kuba2k2/T1200/ExpAdapter/hardware/v1.0/ExpAdapter_v1.0-sch.png

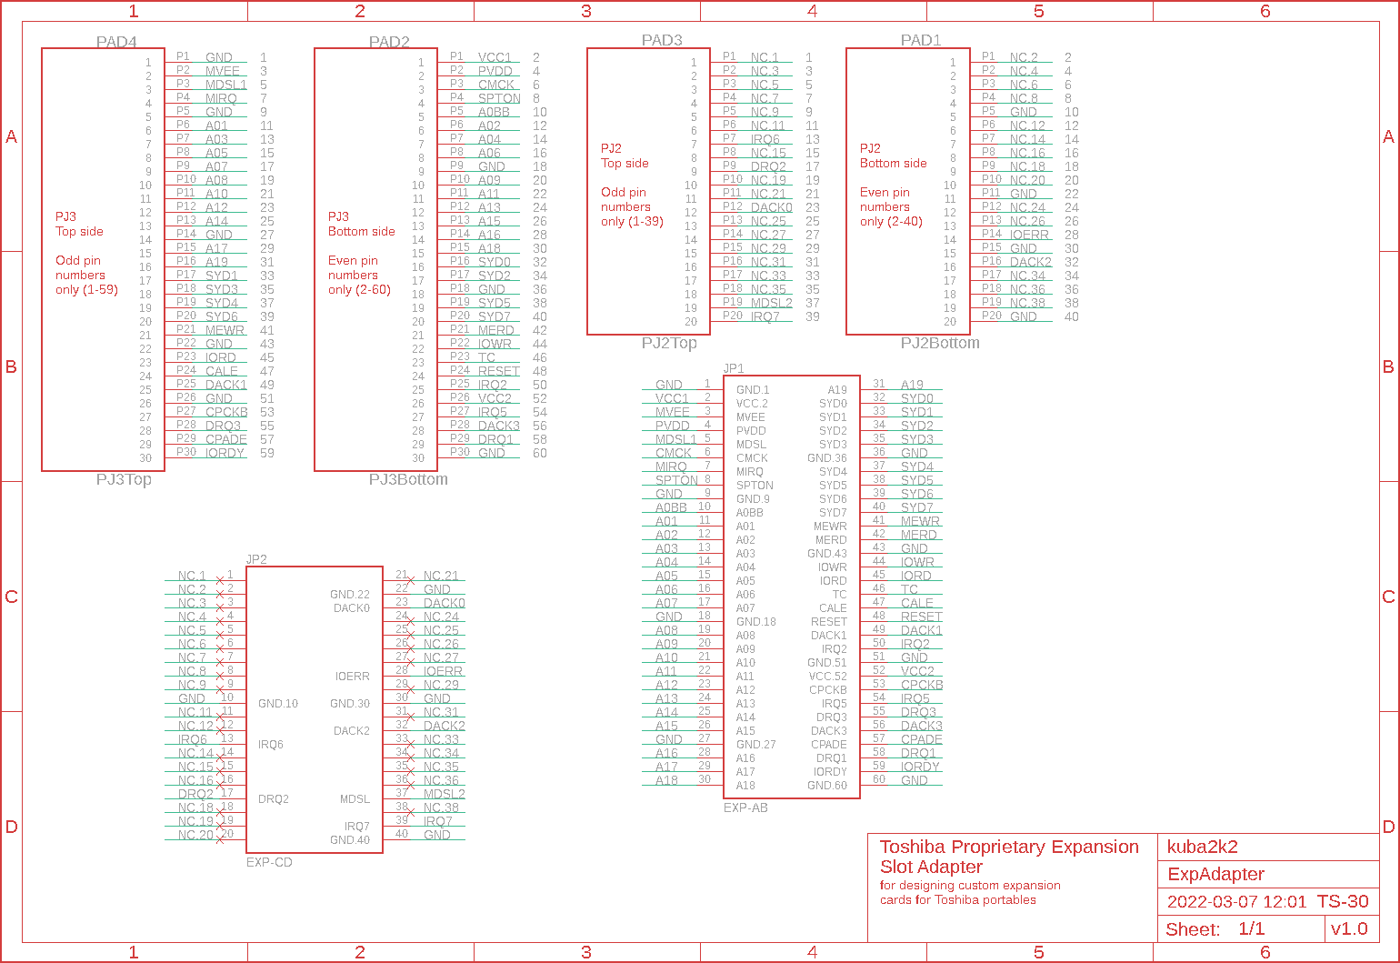
ExpAdapter/hardware/v1.0/ExpAdapter_v1.0-sch.png
