kuba2k2/T1200/ExpAdapter/hardware/v1.0/ExpAdapter_v1.0-top.png

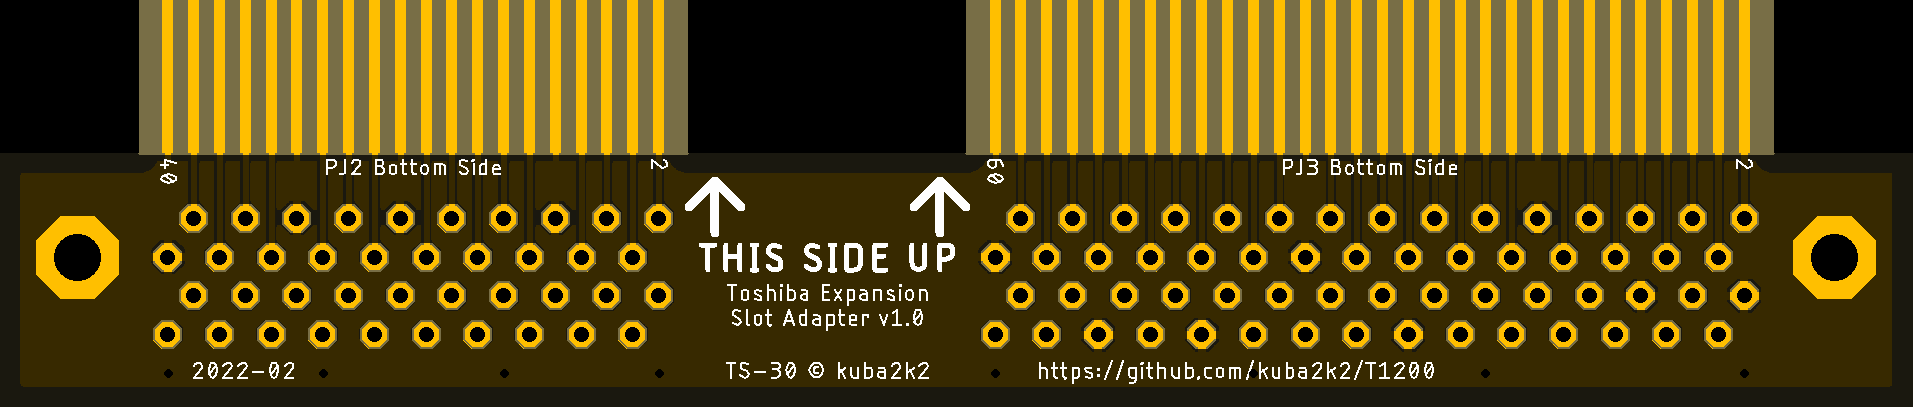
ExpAdapter/hardware/v1.0/ExpAdapter_v1.0-top.png
