kuba2k2/T1200/PSU/hardware/v1.0/PSU_v1.0-sch-sheet1.png

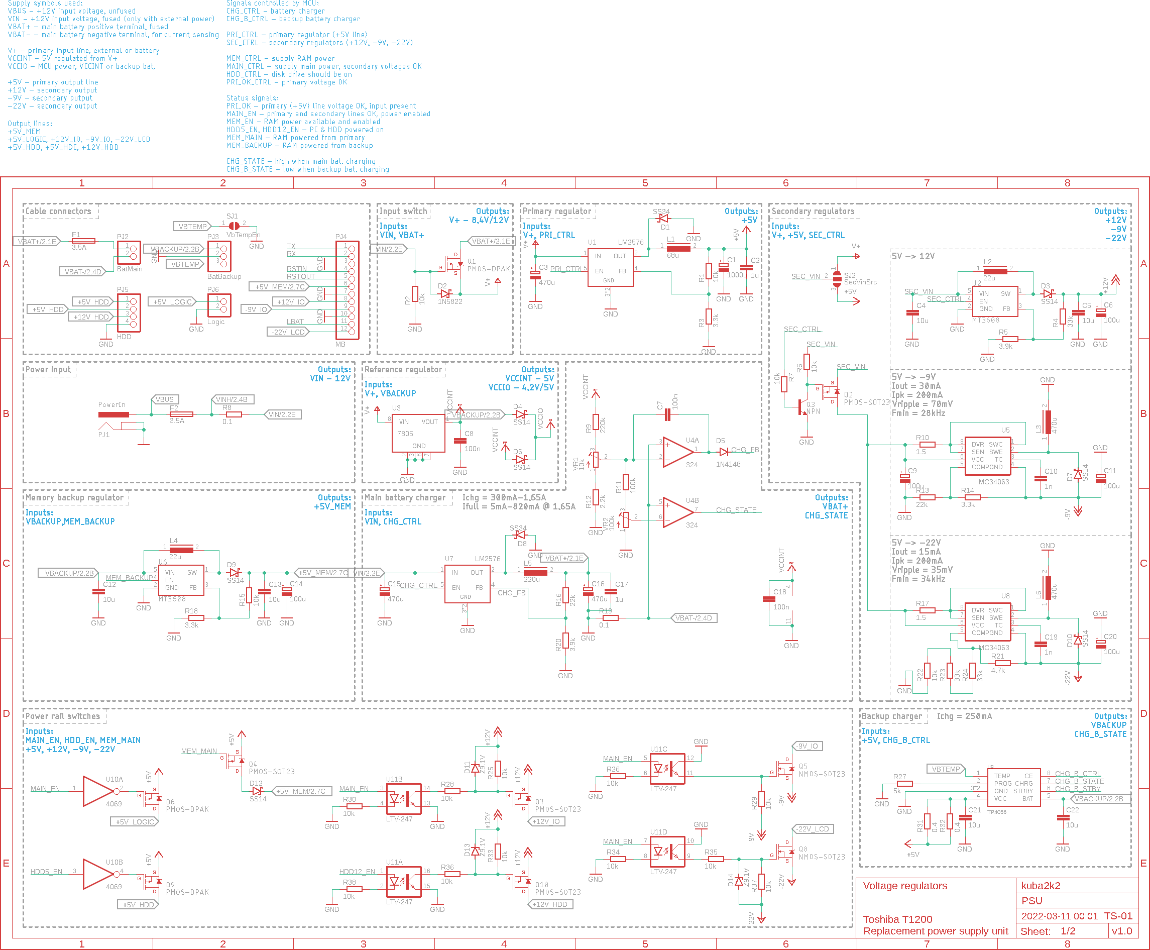
PSU/hardware/v1.0/PSU_v1.0-sch-sheet1.png
