kuba2k2/T1200/PSU/hardware/PSU.brd

## EAGLE design PSU/hardware/PSU.brd (2023-04-14)

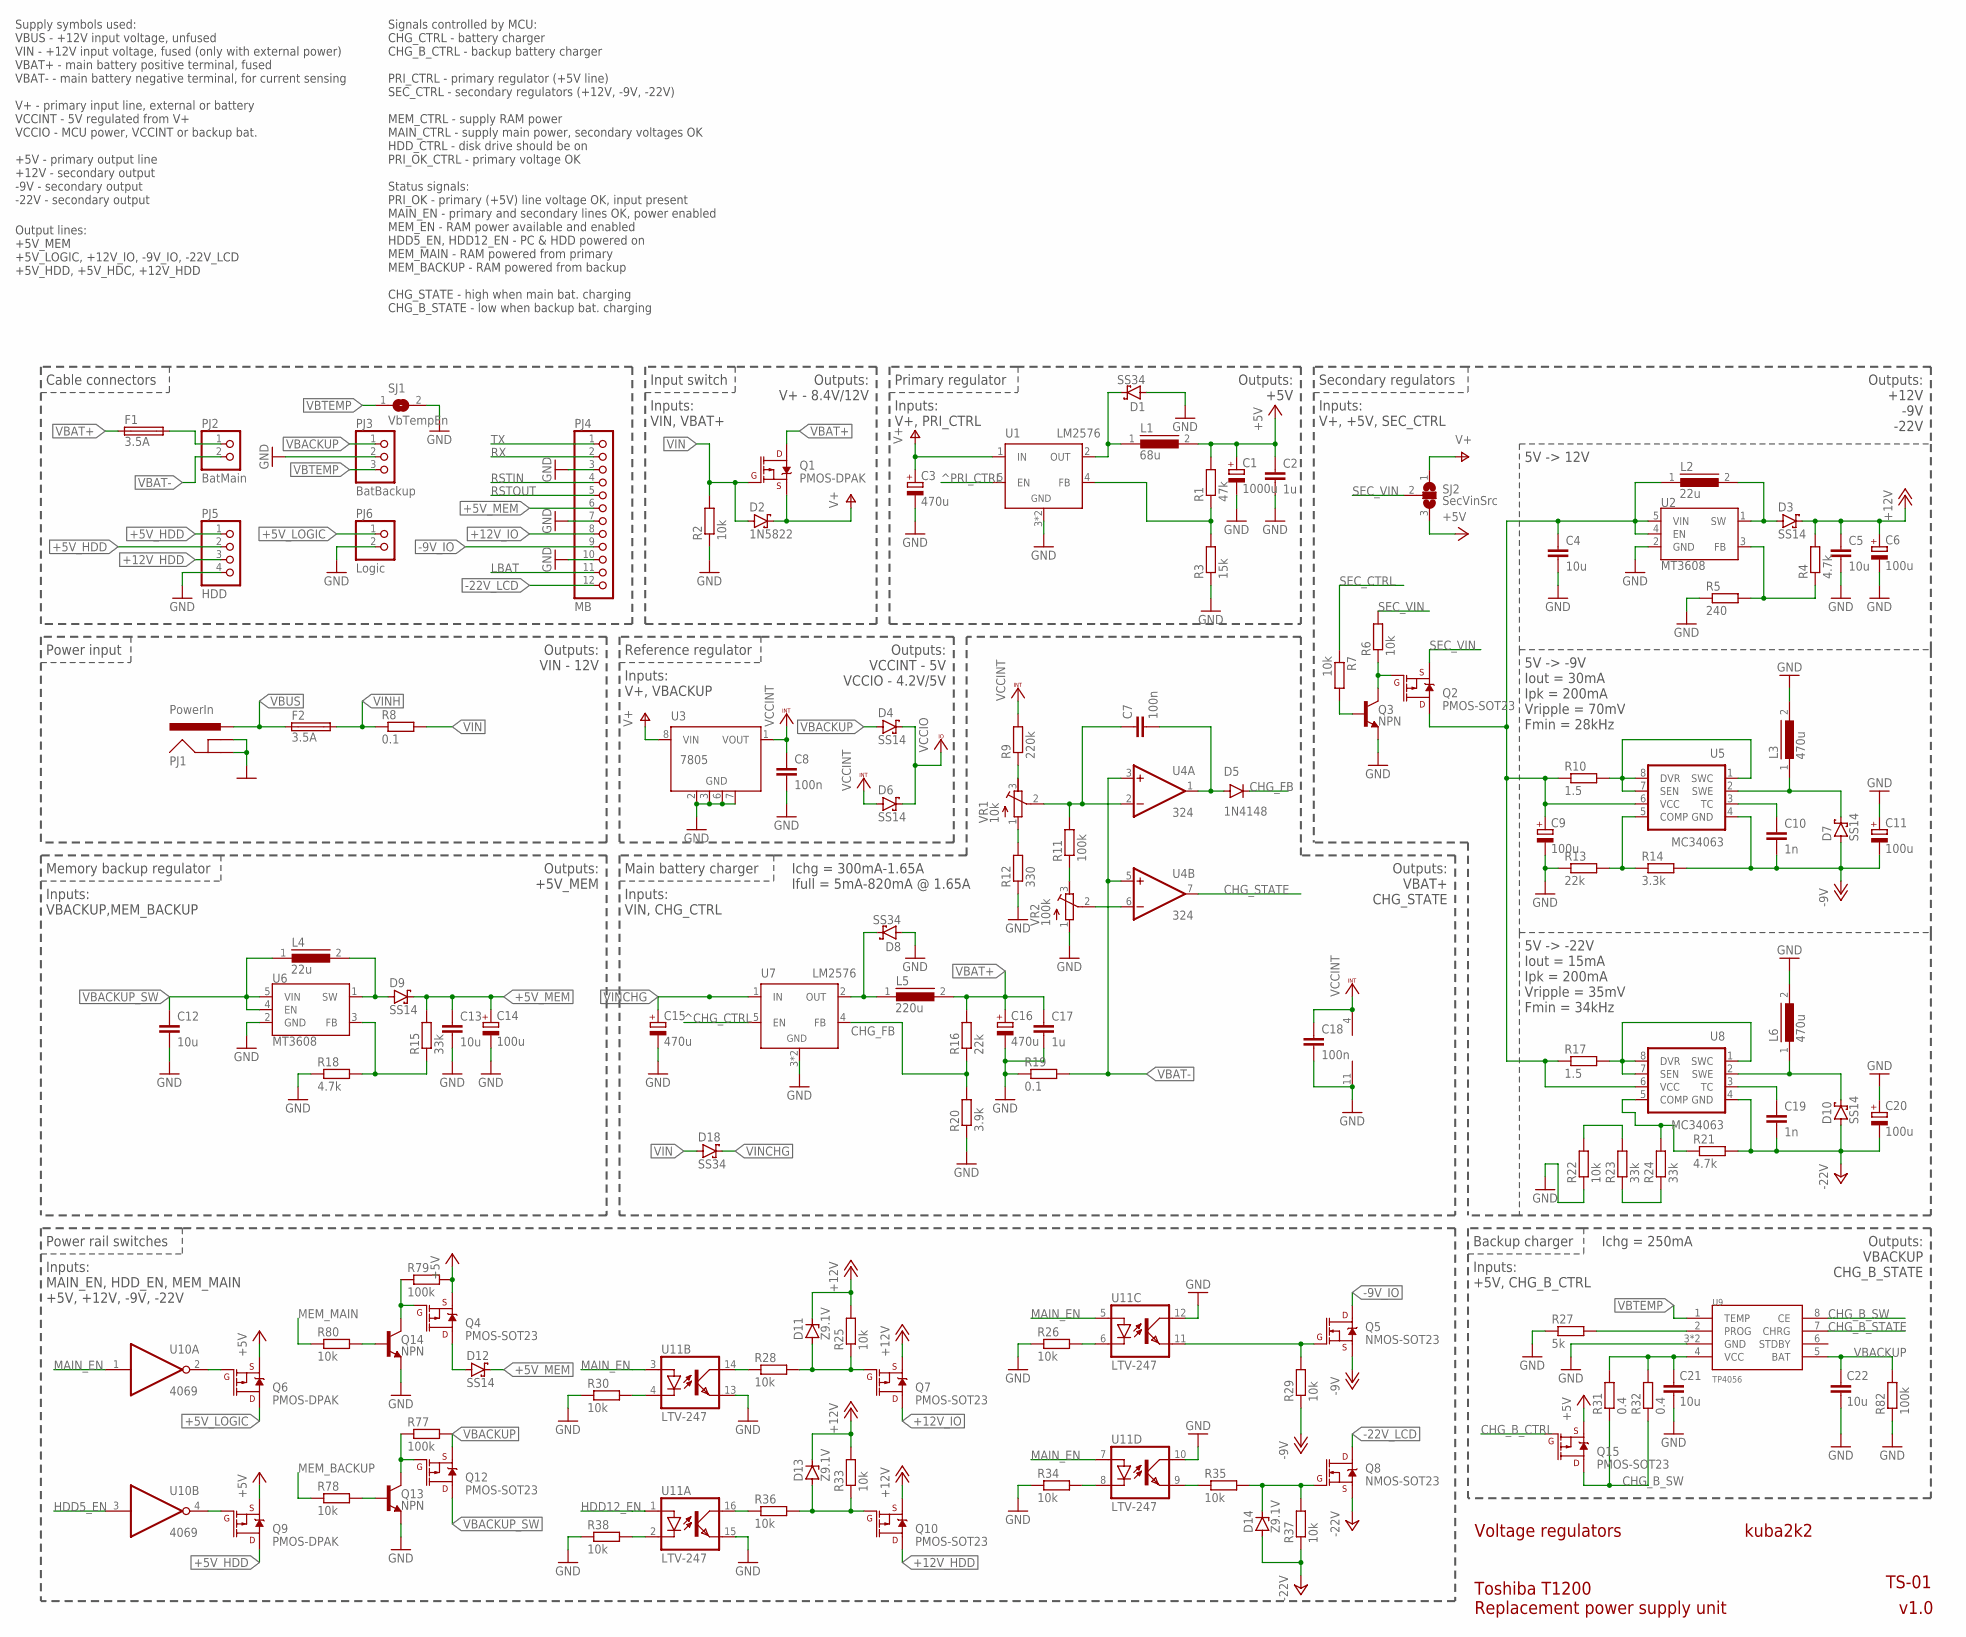
[picture p8: schematic PSU.sch, sheet 1]

Parts:
C1: 1000u; E5-10,5
C2, C17: 1u; C050-024X044
C3, C15, C16: 470u; E3,5-8
C4, C5, C12, C13, C21, C22: 10u; C1206
C6, C9, C11, C14, C20: 100u; E3,5-8
C7, C8, C18: 100n; C0805
C10, C19: 1n; C0805
D1, D8, D18: SS34; SMC
D2: 1N5822; F126Z12
D3, D4, D6, D7, D9, D10, D12: SS14; DO-214AC
D5: 1N4148; DO35-7
D11, D13, D14: Z9.1V; DO34Z7
F1, F2: 3.5A; 2512
L1: 68u; SFT1030
L2, L4: 22u; DR127
L3, L6: 470u; COIL0608
L5: 220u; SFT1030
PJ1: PowerIn; POWER_JACK_PTH
PJ2: BatMain; JST-PH2-4.00
PJ3: BatBackup; JST-PH3
PJ4: MB; JST-PH12
PJ5: HDD; JST-PH4-2.54
PJ6: Logic; JST-PH2-2.54
Q1, Q6, Q9: PMOS-DPAK; TO-252/DPAK
Q2, Q4, Q7, Q10, Q12, Q15: PMOS-SOT23; SOT23-3
Q3, Q13, Q14: NPN; SOT23-3
Q5, Q8: NMOS-SOT23; SOT23-3
R1: 47k; R0805
R2, R6, R7, R22, R25, R26, R28, R29, R30, R33, R34, R35, R36, R37, R38, R78, R80: 10k; R0805
R3: 15k; R0805
R4, R18, R21: 4.7k; R0805
R5: 240; R0805
R8, R19: 0.1; 0411/15
R9: 220k; R0805
R10, R17: 1.5; 0207/10
R11, R77, R79, R82: 100k; R0805
R12: 330; R0805
R13, R16: 22k; R0805
R14: 3.3k; R0805
R15, R23, R24: 33k; R0805
R20: 3.9k; R0805
R27: 5k; R0805
R31: 0.4; 0207/10
R32: 0.4; R1206
SJ1: VbTempEn; SJ
SJ2: SecVinSrc; SJ_2
U1, U7: LM2576; TO220-52-VIAHOLE
U2, U6: MT3608; SOT23-6
U3: 7805; SO08
U4: 324; SO14
U5, U8: MC34063; SO08
U9: TP4056; SO08-PAD
U10: 4069; SO14
U11: LTV-247; SO16-GULLWING
VR1: 10k; RTRIM3296W
VR2: 100k; RTRIM3296W

Connections:
+5V: C1.+, C2.1, L1.2, Q4.2 (S), Q6.3 (S), Q9.3 (S), Q15.2 (S), R1.2, R79.2, SJ2.3; also elsewhere on the board
+5VHDD_G: Q9.1 (G), U10.4 (O)
+5VLOG_G: Q6.1 (G), U10.2 (O)
+5VMEM_B: Q14.1 (B), R80.2
+5VMEM_D: D12.A, Q4.3 (D)
+5VMEM_G: Q4.1 (G), Q14.3 (C), R79.1
+5V_HDD: PJ5.1, PJ5.2, Q9.2 (D)
+5V_LOGIC: PJ6.1, Q6.2 (D)
+5V_MEM: C13.1, C14.+, D9.C, D12.C, PJ4.6, R15.2; also elsewhere on the board
+12V: C5.1, C6.+, D3.C, D11.C, D13.C, Q7.2 (S), Q10.2 (S), R4.2, R25.2, R33.2; also elsewhere on the board
+12VHDD_C: R36.1, U11.16 (COL)
+12VHDD_G: D13.A, Q10.1 (G), R33.1, R36.2
+12VHDD_N: R38.2, U11.2 (C)
+12VIO_C: R28.1, U11.14 (COL)
+12VIO_G: D11.A, Q7.1 (G), R25.1, R28.2
+12VIO_N: R30.2, U11.4 (C)
+12V_FB: R4.1, R5.2, U2.3 (FB)
+12V_HDD: PJ5.3, Q10.3 (D)
+12V_IO: PJ4.8, Q7.3 (D)
+12V_SW: D3.A, L2.2, U2.1 (SW)
-9V: C10.2, C11.-, D7.A, Q5.2 (S), R14.2, R29.1, U5.4 (GND); also elsewhere on the board
-9VIO_G: Q5.1 (G), R29.2, U11.11 (EMIT)
-9VIO_N: R26.2, U11.6 (C)
-9V_COMP: R13.2, R14.1, U5.5 (COMP)
-9V_IO: PJ4.9, Q5.3 (D)
-9V_SWC: R10.2, U5.1 (SWC), U5.7 (SEN), U5.8 (DVR)
-9V_SWE: D7.C, L3.1, U5.2 (SWE)
-9V_TC: C10.1, U5.3 (TC)
-22V: C19.2, C20.-, D10.A, D14.A, Q8.2 (S), R21.2, R37.1, U8.4 (GND); also elsewhere on the board
-22VLCD_E: R35.1, U11.9 (EMIT)
-22VLCD_G: D14.C, Q8.1 (G), R35.2, R37.2
-22VLCD_N: R34.2, U11.8 (C)
-22V_COMP1: R21.1, R24.2, U8.5 (COMP)
-22V_COMP2: R23.1, R24.1
-22V_COMP3: R22.2, R23.2
-22V_LCD: PJ4.12, Q8.3 (D)
-22V_SWC: R17.2, U8.1 (SWC), U8.7 (SEN), U8.8 (DVR)
-22V_SWE: D10.C, L6.1, U8.2 (SWE)
-22V_TC: C19.1, U8.3 (TC)
CC_VAL: C7.1, R11.2, U4.2 (-IN), VR1.2 (S)
CHG_B_CTRL: Q15.1 (G); also elsewhere on the board
CHG_B_PROG: R27.2, U9.2 (PROG)
CHG_B_STATE: U9.7 (CHRG); also elsewhere on the board
CHG_B_SW: Q15.3 (D), R31.1, R32.1, U9.8 (CE)
CHG_B_VCC: C21.1, R31.2, R32.2, U9.4 (VCC)
CHG_DIV1: R11.1, VR2.3 (E)
CHG_DIV2: R12.2, VR1.1 (A)
CHG_DIV3: R9.1, VR1.3 (E)
CHG_FB: D5.C, R16.1, R20.2, U7.4 (FB)
CHG_FB_OUT: C7.2, D5.A, U4.1 (OUT)
CHG_OUT: D8.C, L5.1, U7.2 (OUT)
CHG_STATE: U4.7 (OUT); also elsewhere on the board
FULL_VAL: U4.6 (-IN), VR2.2 (S)
GND: C1.-, C2.2, C3.-, C4.2, C5.2, C6.-, C8.2, C9.-, C11.+, C12.2, C13.2, C14.-, C15.-, C16.-, C17.2, C18.2, C20.+, C21.2, C22.2, D1.A, D8.A, L3.2, L6.2, PJ1.GND, PJ1.GNDBREAK, PJ3.2, PJ4.3, PJ4.7, PJ4.10, PJ5.4, PJ6.2, Q3.2 (E), Q13.2 (E), Q14.2 (E), R2.1, R3.1, R5.1, R12.1, R13.1, R18.1, R19.1, R20.1, R22.1, R26.1, R27.1, R30.1, R34.1, R38.1, R82.1, SJ1.2, U1.3 (GND), U1.TAB (GND), U2.2 (GND), U3.2 (GND), U3.3 (GND), U3.6 (GND), U3.7 (GND), U4.11 (V-), U6.2 (GND), U7.3 (GND), U7.TAB (GND), U9.3 (GND), U9.PAD (GND), U11.10 (COL), U11.12 (COL), U11.13 (EMIT), U11.15 (EMIT), VR2.1 (A); also elsewhere on the board
HDD5_EN: U10.3 (I); also elsewhere on the board
HDD12_EN: U11.1 (A); also elsewhere on the board
LBAT: PJ4.11; also elsewhere on the board
MAIN_EN: U10.1 (I), U11.3 (A), U11.5 (A), U11.7 (A); also elsewhere on the board
MB_FB: R15.1, R18.2, U6.3 (FB)
MB_SW: D9.A, L4.2, U6.1 (SW)
MEM_BACKUP: R78.1; also elsewhere on the board
MEM_MAIN: R80.1; also elsewhere on the board
PRI_FB: R1.1, R3.2, U1.4 (FB)
PRI_OUT: D1.C, L1.1, U1.2 (OUT)
RSTIN: PJ4.4; also elsewhere on the board
RSTOUT: PJ4.5; also elsewhere on the board
RX: PJ4.2; also elsewhere on the board
SECV_B: Q3.1 (B), R7.2
SECV_G: Q2.1 (G), Q3.3 (C), R6.1
SEC_CTRL: R7.1; also elsewhere on the board
SEC_VIN: Q2.2 (S), R6.2, SJ2.2
SEC_VIN_SW: C4.1, C9.+, L2.1, Q2.3 (D), R10.1, R17.1, U2.4 (EN), U2.5 (VIN), U5.6 (VCC), U8.6 (VCC)
TX: PJ4.1; also elsewhere on the board
V+: C3.+, D2.C, Q1.3 (S), SJ2.1, U1.1 (IN), U3.8 (VIN); also elsewhere on the board
VBACKUP: C22.1, D4.A, PJ3.1, Q12.2 (S), R77.2, R82.2, U9.5 (BAT); also elsewhere on the board
VBACKUP_SW: C12.1, L4.1, Q12.3 (D), U6.4 (EN), U6.5 (VIN)
VBACKUP_SW_B: Q13.1 (B), R78.2
VBACKUP_SW_G: Q12.1 (G), Q13.3 (C), R77.1
VBAT+: C16.+, C17.1, F1.1, L5.2, Q1.2 (D), R16.2; also elsewhere on the board
VBAT-: PJ2.2, R19.2, U4.3 (+IN), U4.5 (+IN); also elsewhere on the board
VBAT_RAW: F1.2, PJ2.1
VBTEMP: PJ3.3, SJ1.1, U9.1 (TEMP)
VBUS: F2.1, PJ1.PWR
VCCINT: C8.1, C18.1, D6.A, R9.2, U3.1 (VOUT), U4.4 (V+); also elsewhere on the board
VCCIO: D4.C, D6.C; also elsewhere on the board
VIN: D2.A, D18.A, Q1.1 (G), R2.2, R8.2; also elsewhere on the board
VINCHG: C15.+, D18.C, U7.1 (IN)
VINH: F2.2, R8.1; also elsewhere on the board
^CHG_CTRL: U7.5 (EN); also elsewhere on the board
^PRI_CTRL: U1.5 (EN); also elsewhere on the board

Notes on the sheet:
Supply symbols used: VBUS - +12V input voltage, unfused VIN - +12V input voltage, fused (only with external power) VBAT+ - main battery positive terminal, fused VBAT- - main battery negative terminal, for current sensing V+ - primary input line, external or battery VCCINT - 5V regulated from V+ VCC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
Signals controlled by MCU: CHG_CTRL - battery charger CHG_B_CTRL - backup battery charger PRI_CTRL - primary regulator (+5V line) SEC_CTRL - secondary regulators (+12V, -9V, -22V) MEM_CTRL - supply RAM power MAIN_CTRL - supply main power, secondary voltages OK HDD_CTRL - disk drive should be on PRI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
Output lines: +5V_MEM +5V_LOGIC, +12V_IO, -9V_IO, -22V_LCD +5V_HDD, +5V_HDC, +12V_HDD
Primary regulator
Cable connectors
Power input
Outputs: VIN - 12V
Input switch
Outputs: V+ - 8.4V/12V
Outputs: +5V
Inputs: V+, PRI_CTRL
Inputs: VIN, VBAT+
Secondary regulators
Inputs: V+, +5V, SEC_CTRL
Outputs: +12V -9V -22V
5V -> 12V
5V -> -9V Iout = 30mA Ipk = 200mA Vripple = 70mV Fmin = 28kHz
5V -> -22V Iout = 15mA Ipk = 200mA Vripple = 35mV Fmin = 34kHz
Backup charger
Ichg = 250mA
Inputs: +5V, CHG_B_CTRL
Outputs: VBACKUP CHG_B_STATE
Ichg = 300mA-1.65A Ifull = 5mA-820mA @ 1.65A
Memory backup regulator
Inputs: VBACKUP,MEM_BACKUP
Outputs: +5V_MEM
Reference regulator
Inputs: V+, VBACKUP
Outputs: VCCINT - 5V VCCIO - 4.2V/5V
Main battery charger
Inputs: VIN, CHG_CTRL
Outputs: VBAT+ CHG_STATE
Voltage regulators
Power rail switches
Inputs: MAIN_EN, HDD_EN, MEM_MAIN +5V, +12V, -9V, -22V
kuba2k2
TS-01
v1.0
Toshiba T1200 Replacement power supply unit

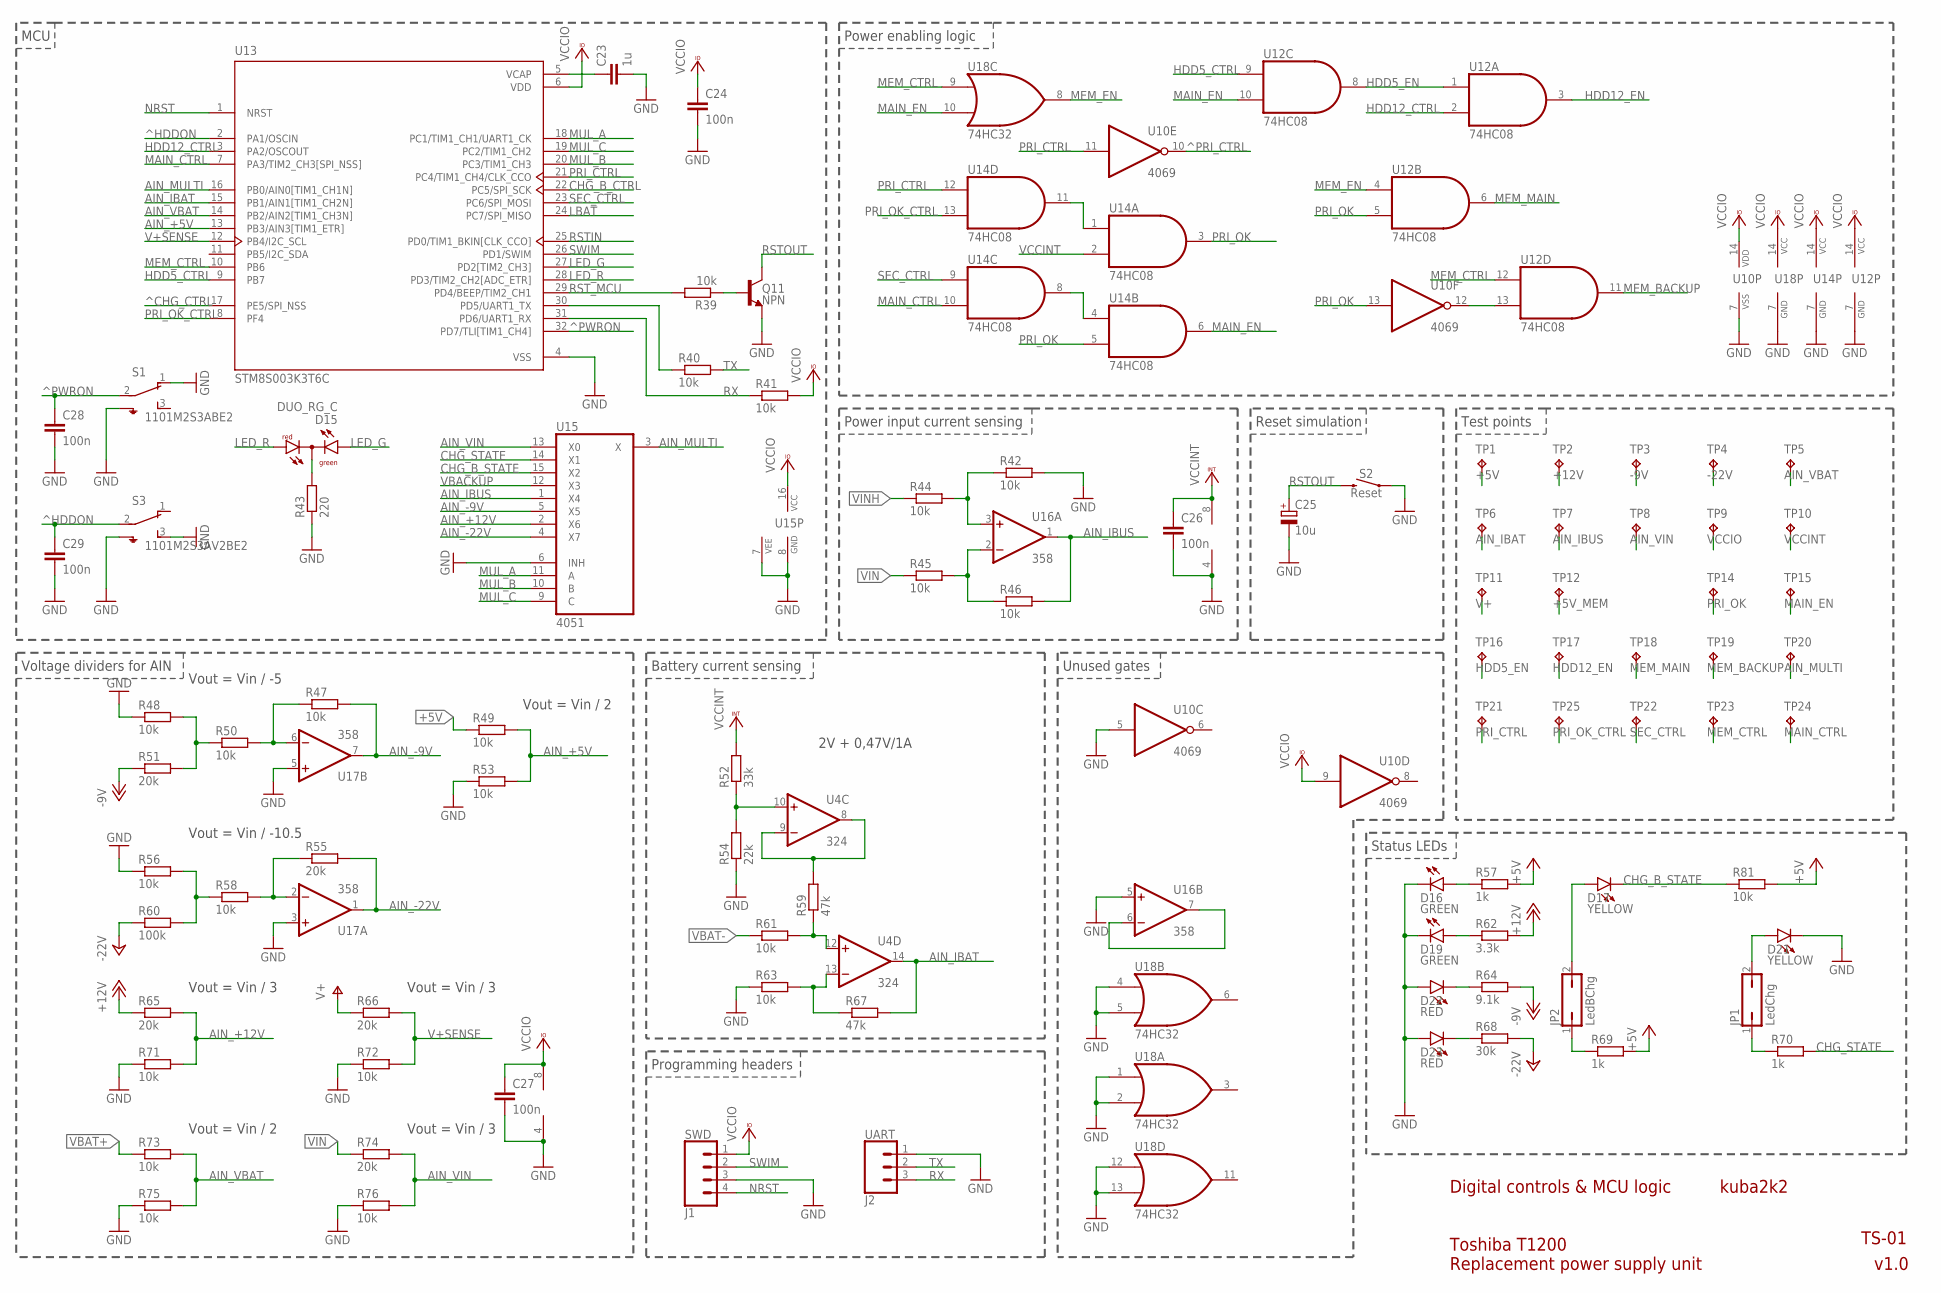
[picture p9: schematic PSU.sch, sheet 2]

Parts:
C23: 1u; C050-024X044
C24, C26, C27, C28, C29: 100n; C0805
C25: 10u; E2-5
D15: DUO_RG_C; DUOLED-C-5MM
D16, D19: GREEN; CHIP-LED0805
D17, D21: YELLOW; CHIP-LED0805
D22, D23: RED; CHIP-LED0805
J1: SWD; 1X04
J2: UART; 1X03
JP1: LedChg; JP1
JP2: LedBChg; JP1
Q11: NPN; SOT23-3
R39, R40, R41, R42, R44, R45, R46, R47, R48, R49, R50, R53, R56, R58, R61, R63, R71, R72, R73, R75, R76, R81: 10k; R0805
R43: 220; R0805
R51, R55, R65, R66, R74: 20k; R0805
R52: 33k; R0805
R54: 22k; R0805
R57, R69, R70: 1k; R0805
R59, R67: 47k; R0805
R60: 100k; R0805
R62: 3.3k; R0805
R64: 9.1k; R0805
R68: 30k; R0805
S1: 1101M2S3ABE2
S2: Reset; TACTILE_SWITCH_SMD_6.2MM_TALL
S3: 1101M2S3AV2BE2
TP1, TP2, TP3, TP4, TP5, TP6, TP7, TP8, TP9, TP10, TP11, TP12, TP14, TP15, TP16, TP17, TP18, TP19, TP20, TP21, TP22, TP23, TP24, TP25: TPB1,27; B1,27
U4: 324; SO14
U10: 4069; SO14
U12, U14: 74HC08; SO14
U13: STM8S003K3T6C; QFP80P900X900X160-32N
U15: 4051; SO16
U16, U17: 358; SO08
U18: 74HC32; SO14

Connections:
+5V: R49.1, R57.2, R69.2, R81.2, TP1.TP; also elsewhere on the board
+5V_MEM: TP12.TP; also elsewhere on the board
+12V: R62.2, R65.1, TP2.TP; also elsewhere on the board
-9V: R51.1, R64.2, TP3.TP; also elsewhere on the board
-22V: R60.1, R68.2, TP4.TP; also elsewhere on the board
AIN9DIV: R48.2, R50.1, R51.2
AIN9N: R47.1, R50.2, U17.6 (-IN)
AIN22DIV: R56.2, R58.1, R60.2
AIN22N: R55.1, R58.2, U17.2 (-IN)
AIN_+5V: R49.2, R53.2, U13.13 (PB3/AIN3[TIM1_ETR])
AIN_+12V: R65.2, R71.2, U15.2 (X6)
AIN_-9V: R47.2, U15.5 (X5), U17.7 (OUT)
AIN_-22V: R55.2, U15.4 (X7), U17.1 (OUT)
AIN_IBAT: R67.2, TP6.TP, U4.14 (OUT), U13.15 (PB1/AIN1[TIM1_CH2N])
AIN_IBUS: R46.2, TP7.TP, U15.1 (X4), U16.1 (OUT)
AIN_MULTI: TP20.TP, U13.16 (PB0/AIN0[TIM1_CH1N]), U15.3 (X)
AIN_VBAT: R73.2, R75.2, TP5.TP, U13.14 (PB2/AIN2[TIM1_CH3N])
AIN_VIN: R74.2, R76.2, TP8.TP, U15.13 (X0)
CHG_B_CTRL: U13.22 (PC5/SPI_SCK); also elsewhere on the board
CHG_B_STATE: D17.C, R81.1, U15.15 (X2); also elsewhere on the board
CHG_STATE: R70.2, U15.14 (X1); also elsewhere on the board
GND: C23.2, C24.2, C25.-, C26.2, C27.2, C28.2, C29.2, D16.C, D19.C, D21.C, D22.A, D23.A, J1.3, J2.1, Q11.2 (E), R42.2, R43.1, R48.1, R53.1, R54.1, R56.1, R63.1, R71.1, R72.1, R75.1, R76.1, S1.1 (O), S1.S1 (SH), S1.S2 (SH), S2.A2 (1), S3.3 (S), S3.S1 (SH), S3.S2 (SH), U10.5 (I), U10.7 (VSS), U12.7 (GND), U13.4 (VSS), U14.7 (GND), U15.6 (INH), U15.7 (VEE), U15.8 (GND), U16.4 (V-), U16.5 (+IN), U17.3 (+IN), U17.4 (V-), U17.5 (+IN), U18.1 (I0), U18.2 (I1), U18.4 (I0), U18.5 (I1), U18.7 (GND), U18.12 (I0), U18.13 (I1); also elsewhere on the board
HDD5_CTRL: U12.9 (I0), U13.9 (PB7)
HDD5_EN: TP16.TP, U12.1 (I0), U12.8 (O); also elsewhere on the board
HDD12_CTRL: U12.2 (I1), U13.3 (PA2/OSCOUT)
HDD12_EN: TP17.TP, U12.3 (O); also elsewhere on the board
IBAT_DIVN: R59.2, U4.8 (OUT), U4.9 (-IN)
IBAT_DIVP: R52.1, R54.2, U4.10 (+IN)
IBAT_N: R63.2, R67.1, U4.13 (-IN)
IBAT_P: R59.1, R61.2, U4.12 (+IN)
IBUS_N: R45.2, R46.1, U16.2 (-IN)
IBUS_P: R42.1, R44.2, U16.3 (+IN)
LBAT: U13.24 (PC7/SPI_MISO); also elsewhere on the board
LED1_+5: D16.A, R57.1
LED1_+12: D19.A, R62.1
LED1_-9: D22.C, R64.1
LED1_-22: D23.C, R68.1
LED2_EN: D17.A, JP2.2
LED2_P: JP2.1, R69.1
LED3_EN: D21.A, JP1.2
LED3_P: JP1.1, R70.1
LED_CC: D15.C, R43.2
LED_G: D15.AX (AG), U13.27 (PD2[TIM2_CH3])
LED_R: D15.AR, U13.28 (PD3/TIM2_CH2[ADC_ETR])
MAIN_CTRL: TP24.TP, U13.7 (PA3/TIM2_CH3[SPI_NSS]), U14.10 (I1)
MAIN_EN: TP15.TP, U12.10 (I1), U14.6 (O), U18.10 (I1); also elsewhere on the board
MAIN_MID: U14.4 (I0), U14.8 (O)
MB_MID: U10.12 (O), U12.13 (I1)
MEM_BACKUP: TP19.TP, U12.11 (O); also elsewhere on the board
MEM_CTRL: TP23.TP, U12.12 (I0), U13.10 (PB6), U18.9 (I0)
MEM_EN: U12.4 (I0), U18.8 (O)
MEM_MAIN: TP18.TP, U12.6 (O); also elsewhere on the board
MUL_A: U13.18 (PC1/TIM1_CH1/UART1_CK), U15.11 (A)
MUL_B: U13.20 (PC3/TIM1_CH3), U15.10 (B)
MUL_C: U13.19 (PC2/TIM1_CH2), U15.9 (C)
NRST: J1.4, U13.1 (NRST)
PRI_CTRL: TP21.TP, U10.11 (I), U13.21 (PC4/TIM1_CH4/CLK_CCO), U14.12 (I0)
PRI_MID: U14.1 (I0), U14.11 (O)
PRI_OK: TP14.TP, U10.13 (I), U12.5 (I1), U14.3 (O), U14.5 (I1)
PRI_OK_CTRL: TP25.TP, U13.8 (PF4), U14.13 (I1)
RSTIN: U13.25 (PD0/TIM1_BKIN[CLK_CCO]); also elsewhere on the board
RSTOUT: C25.+, Q11.3 (C), S2.B2 (2); also elsewhere on the board
RST_B: Q11.1 (B), R39.1
RST_MCU: R39.2, U13.29 (PD4/BEEP/TIM2_CH1)
RX: J2.3, R41.1, U13.31 (PD6/UART1_RX); also elsewhere on the board
SEC_CTRL: TP22.TP, U13.23 (PC6/SPI_MOSI), U14.9 (I0); also elsewhere on the board
SWIM: J1.2, U13.26 (PD1/SWIM)
TX: J2.2, R40.2; also elsewhere on the board
TX_MCU: R40.1, U13.30 (PD5/UART1_TX)
U18B: U16.6 (-IN), U16.7 (OUT)
V+: R66.1, TP11.TP; also elsewhere on the board
V+SENSE: R66.2, R72.2, U13.12 (PB4/I2C_SCL)
VBACKUP: U15.12 (X3); also elsewhere on the board
VBAT+: R73.1; also elsewhere on the board
VBAT-: R61.1; also elsewhere on the board
VCAP: C23.1, U13.5 (VCAP)
VCCINT: C26.1, R52.2, TP10.TP, U14.2 (I1), U16.8 (V+); also elsewhere on the board
VCCIO: C24.1, C27.1, J1.1, R41.2, TP9.TP, U10.9 (I), U10.14 (VDD), U12.14 (VCC), U13.6 (VDD), U14.14 (VCC), U15.16 (VCC), U17.8 (V+), U18.14 (VCC); also elsewhere on the board
VIN: R45.1, R74.1; also elsewhere on the board
VINH: R44.1; also elsewhere on the board
^CHG_CTRL: U13.17 (PE5/SPI_NSS); also elsewhere on the board
^HDDON: C29.1, S3.2, U13.2 (PA1/OSCIN)
^PRI_CTRL: U10.10 (O); also elsewhere on the board
^PWRON: C28.1, S1.2, U13.32 (PD7/TLI[TIM1_CH4])

Notes on the sheet:
MCU
Power enabling logic
Voltage dividers for AIN
Vout = Vin / -5
Vout = Vin / -10.5
Vout = Vin / 3
Vout = Vin / 2
Programming headers
Battery current sensing
2V + 0,47V/1A
Status LEDs
Power input current sensing
Unused gates
Reset simulation
Test points
Digital controls & MCU logic
kuba2k2
TS-01
v1.0
Toshiba T1200 Replacement power supply unit

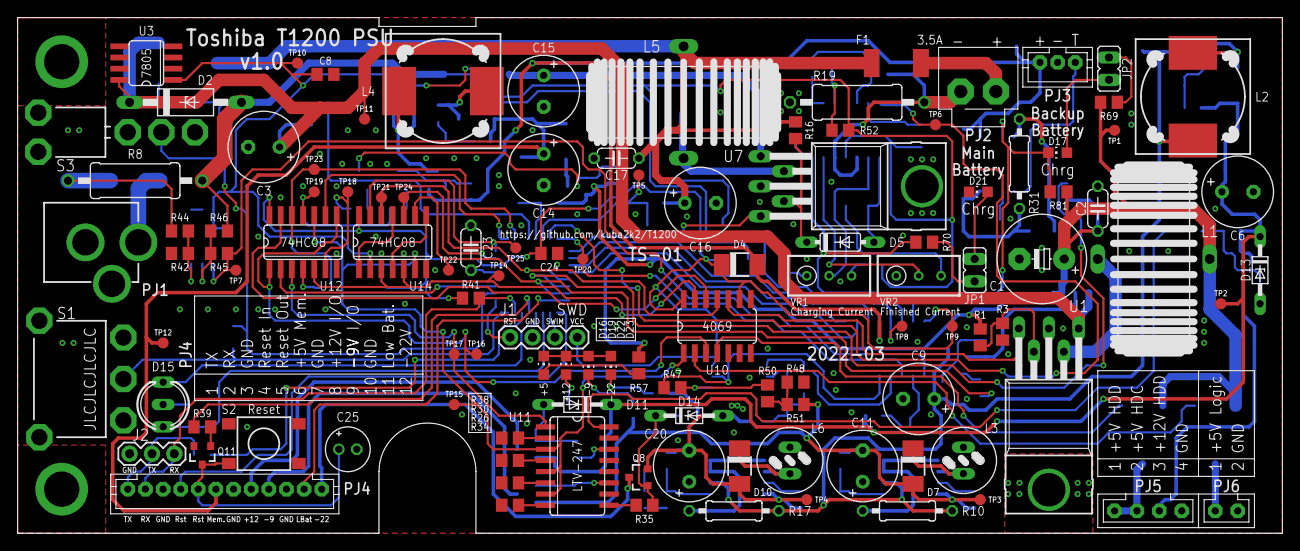
[picture p10: board PSU.brd from above]

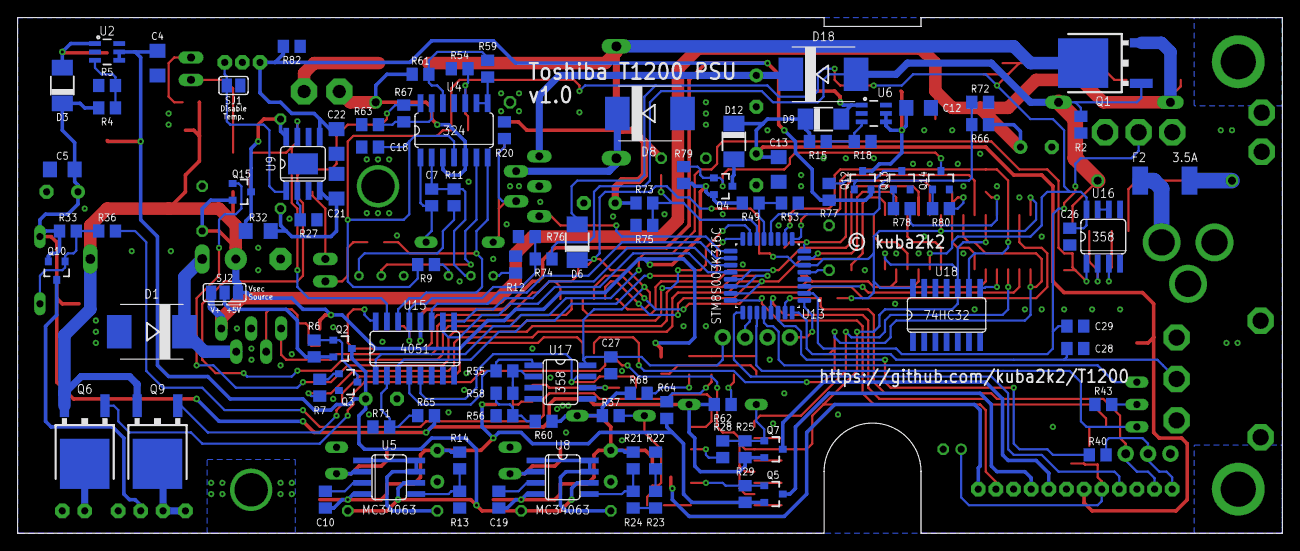
[picture p11: board PSU.brd from below]

Board: 2 copper layers, 143.5 x 58.5 mm, 215 parts (102 on the bottom side), 144 nets.
