kuba2k2/T1200/ExpAdapter/hardware/v1.0/ExpAdapter_v1.0.brd

## EAGLE design ExpAdapter/hardware/v1.0/ExpAdapter_v1.0.brd (2022-03-07)

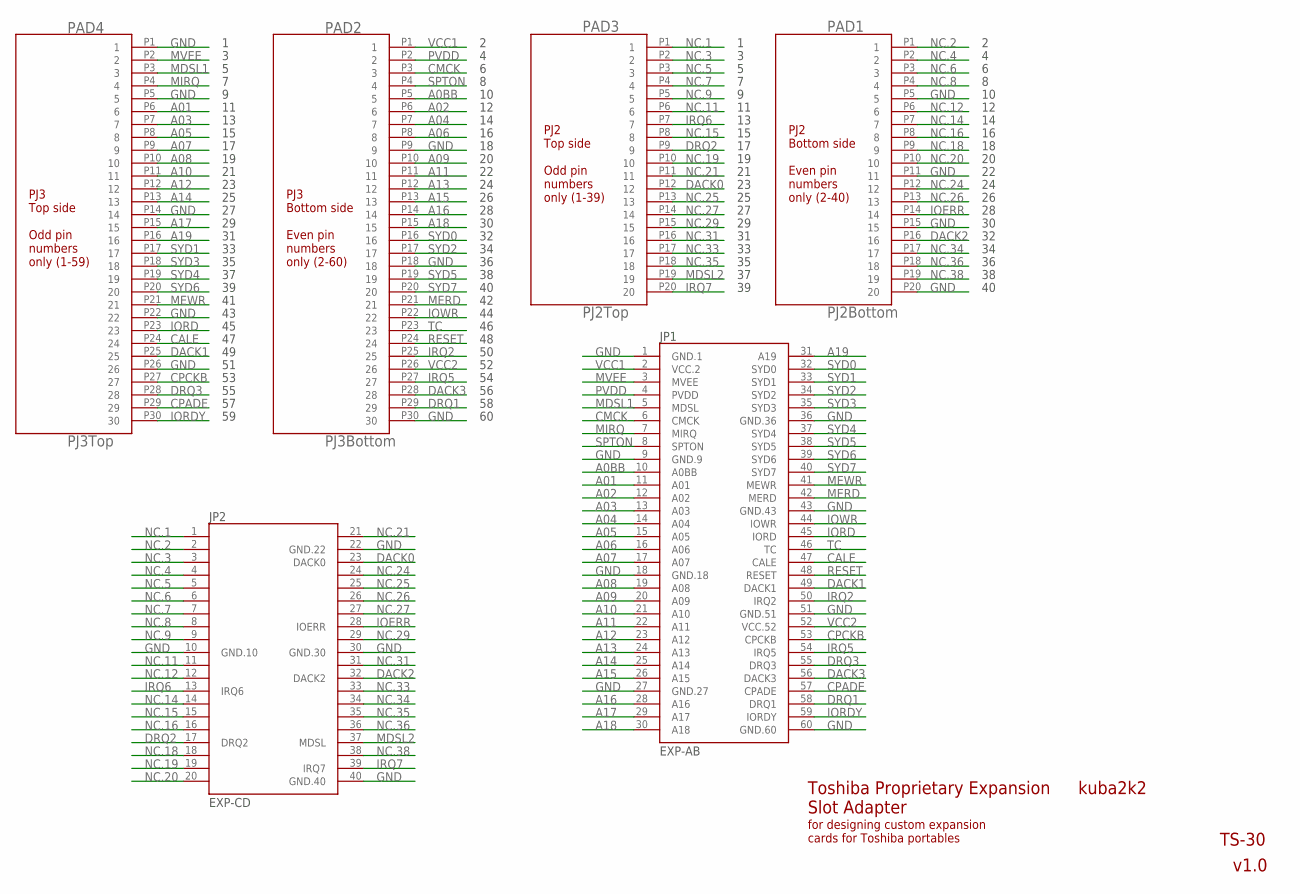
[picture p12: schematic ExpAdapter_v1.0.sch]

Parts:
JP1: EXP-AB; CONN60
JP2: EXP-CD; CONN40
PAD1: PJ2Bottom; PAD20
PAD2: PJ3Bottom; PAD30
PAD3: PJ2Top; PAD20
PAD4: PJ3Top; PAD30

Connections:
A0BB: JP1.10 (A0BB), PAD2.P5 (5)
A01: JP1.11 (A01), PAD4.P6 (6)
A02: JP1.12 (A02), PAD2.P6 (6)
A03: JP1.13 (A03), PAD4.P7 (7)
A04: JP1.14 (A04), PAD2.P7 (7)
A05: JP1.15 (A05), PAD4.P8 (8)
A06: JP1.16 (A06), PAD2.P8 (8)
A07: JP1.17 (A07), PAD4.P9 (9)
A08: JP1.19 (A08), PAD4.P10 (10)
A09: JP1.20 (A09), PAD2.P10 (10)
A10: JP1.21 (A10), PAD4.P11 (11)
A11: JP1.22 (A11), PAD2.P11 (11)
A12: JP1.23 (A12), PAD4.P12 (12)
A13: JP1.24 (A13), PAD2.P12 (12)
A14: JP1.25 (A14), PAD4.P13 (13)
A15: JP1.26 (A15), PAD2.P13 (13)
A16: JP1.28 (A16), PAD2.P14 (14)
A17: JP1.29 (A17), PAD4.P15 (15)
A18: JP1.30 (A18), PAD2.P15 (15)
A19: JP1.31 (A19), PAD4.P16 (16)
CALE: JP1.47 (CALE), PAD4.P24 (24)
CMCK: JP1.6 (CMCK), PAD2.P3 (3)
CPADE: JP1.57 (CPADE), PAD4.P29 (29)
CPCKB: JP1.53 (CPCKB), PAD4.P27 (27)
DACK0: JP2.23 (DACK0), PAD3.P12 (12)
DACK1: JP1.49 (DACK1), PAD4.P25 (25)
DACK2: JP2.32 (DACK2), PAD1.P16 (16)
DACK3: JP1.56 (DACK3), PAD2.P28 (28)
DRQ1: JP1.58 (DRQ1), PAD2.P29 (29)
DRQ2: JP2.17 (DRQ2), PAD3.P9 (9)
DRQ3: JP1.55 (DRQ3), PAD4.P28 (28)
GND: JP1.1 (GND.1), JP1.9 (GND.9), JP1.18 (GND.18), JP1.27 (GND.27), JP1.36 (GND.36), JP1.43 (GND.43), JP1.51 (GND.51), JP1.60 (GND.60), JP2.10 (GND.10), JP2.22 (GND.22), JP2.30 (GND.30), JP2.40 (GND.40), PAD1.P5 (5), PAD1.P11 (11), PAD1.P15 (15), PAD1.P20 (20), PAD2.P9 (9), PAD2.P18 (18), PAD2.P30 (30), PAD4.P1 (1), PAD4.P5 (5), PAD4.P14 (14), PAD4.P22 (22), PAD4.P26 (26)
IOERR: JP2.28 (IOERR), PAD1.P14 (14)
IORD: JP1.45 (IORD), PAD4.P23 (23)
IORDY: JP1.59 (IORDY), PAD4.P30 (30)
IOWR: JP1.44 (IOWR), PAD2.P22 (22)
IRQ2: JP1.50 (IRQ2), PAD2.P25 (25)
IRQ5: JP1.54 (IRQ5), PAD2.P27 (27)
IRQ6: JP2.13 (IRQ6), PAD3.P7 (7)
IRQ7: JP2.39 (IRQ7), PAD3.P20 (20)
MDSL1: JP1.5 (MDSL), PAD4.P3 (3)
MDSL2: JP2.37 (MDSL), PAD3.P19 (19)
MERD: JP1.42 (MERD), PAD2.P21 (21)
MEWR: JP1.41 (MEWR), PAD4.P21 (21)
MIRQ: JP1.7 (MIRQ), PAD4.P4 (4)
MVEE: JP1.3 (MVEE), PAD4.P2 (2)
NC.1: JP2.1 (NC.1), PAD3.P1 (1)
NC.2: JP2.2 (NC.2), PAD1.P1 (1)
NC.3: JP2.3 (NC.3), PAD3.P2 (2)
NC.4: JP2.4 (NC.4), PAD1.P2 (2)
NC.5: JP2.5 (NC.5), PAD3.P3 (3)
NC.6: JP2.6 (NC.6), PAD1.P3 (3)
NC.7: JP2.7 (NC.7), PAD3.P4 (4)
NC.8: JP2.8 (NC.8), PAD1.P4 (4)
NC.9: JP2.9 (NC.9), PAD3.P5 (5)
NC.11: JP2.11 (NC.11), PAD3.P6 (6)
NC.12: JP2.12 (NC.12), PAD1.P6 (6)
NC.14: JP2.14 (NC.14), PAD1.P7 (7)
NC.15: JP2.15 (NC.15), PAD3.P8 (8)
NC.16: JP2.16 (NC.16), PAD1.P8 (8)
NC.18: JP2.18 (NC.18), PAD1.P9 (9)
NC.19: JP2.19 (NC.19), PAD3.P10 (10)
NC.20: JP2.20 (NC.20), PAD1.P10 (10)
NC.21: JP2.21 (NC.21), PAD3.P11 (11)
NC.24: JP2.24 (NC.24), PAD1.P12 (12)
NC.25: JP2.25 (NC.25), PAD3.P13 (13)
NC.26: JP2.26 (NC.26), PAD1.P13 (13)
NC.27: JP2.27 (NC.27), PAD3.P14 (14)
NC.29: JP2.29 (NC.29), PAD3.P15 (15)
NC.31: JP2.31 (NC.31), PAD3.P16 (16)
NC.33: JP2.33 (NC.33), PAD3.P17 (17)
NC.34: JP2.34 (NC.34), PAD1.P17 (17)
NC.35: JP2.35 (NC.35), PAD3.P18 (18)
NC.36: JP2.36 (NC.36), PAD1.P18 (18)
NC.38: JP2.38 (NC.38), PAD1.P19 (19)
PVDD: JP1.4 (PVDD), PAD2.P2 (2)
RESET: JP1.48 (RESET), PAD2.P24 (24)
SPTON: JP1.8 (SPTON), PAD2.P4 (4)
SYD0: JP1.32 (SYD0), PAD2.P16 (16)
SYD1: JP1.33 (SYD1), PAD4.P17 (17)
SYD2: JP1.34 (SYD2), PAD2.P17 (17)
SYD3: JP1.35 (SYD3), PAD4.P18 (18)
SYD4: JP1.37 (SYD4), PAD4.P19 (19)
SYD5: JP1.38 (SYD5), PAD2.P19 (19)
SYD6: JP1.39 (SYD6), PAD4.P20 (20)
SYD7: JP1.40 (SYD7), PAD2.P20 (20)
TC: JP1.46 (TC), PAD2.P23 (23)
VCC1: JP1.2 (VCC.2), PAD2.P1 (1)
VCC2: JP1.52 (VCC.52), PAD2.P26 (26)

Notes on the sheet:
PJ3 Top side Odd pin numbers only (1-59)
PJ3 Bottom side Even pin numbers only (2-60)
PJ2 Top side Odd pin numbers only (1-39)
PJ2 Bottom side Even pin numbers only (2-40)
kuba2k2
v1.0
TS-30
Toshiba Proprietary Expansion Slot Adapter
for designing custom expansion cards for Toshiba portables

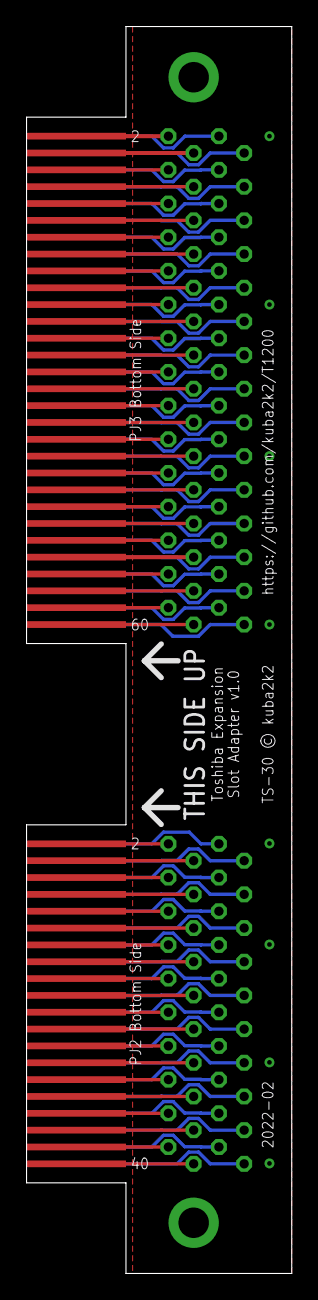
[picture p13: board ExpAdapter_v1.0.brd from above]

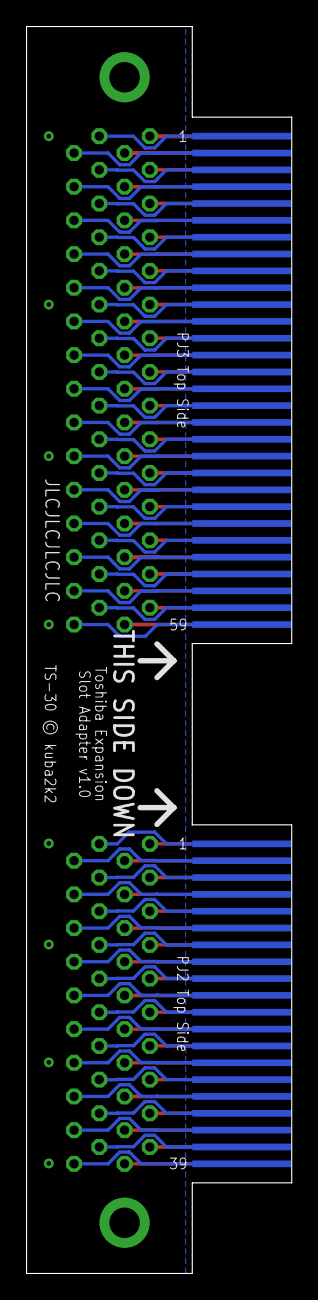
[picture p14: board ExpAdapter_v1.0.brd from below]

Board: 2 copper layers, 20.0 x 94.0 mm, 6 parts (2 on the bottom side), 89 nets.
