kuba2k2/T1200/(commit log)

2022-03-07 [HW/ExpAdapter] Add design files
    [ExpAdapter.brd, ExpAdapter.sch]
2022-03-07 [HW/ExpAdapter] Release v1.0
    [ExpAdapter_v1.0.brd, ExpAdapter_v1.0.sch]
2022-03-11 [HW/PSU] Add design files
    [PSU.brd, PSU.sch]
2022-03-11 [HW/PSU] Release v1.0
    [PSU_v1.0.brd, PSU_v1.0.sch]
2022-11-14 [HW/PSU] Fix MT3608 feedback divider values
    [PSU.brd, PSU.sch]
2022-11-15 [HW/PSU] Fix secondary 12V regulator enabling
    [PSU.brd, PSU.sch]
2022-12-03 [HW/PSU] Fix LM2576 enable signals level
    [PSU.brd, PSU.sch]
2022-12-03 [HW/PSU] Fix backup regulator enabling
    [PSU.brd, PSU.sch]
2023-04-05 [HW/PSU] Fix backup regulator enabling logic level
    [PSU.brd, PSU.sch]
2023-04-05 [HW/PSU] Fix +5V_MEM enabling logic level
    [PSU.brd, PSU.sch]
2023-04-09 [HW/PSU] Fix open-drain GPIO usage
    [PSU.brd, PSU.sch]
2023-04-09 [HW/PSU] Fix backup charger enabling, remove standby LEDs
    [PSU.brd, PSU.sch]
2023-04-09 [HW/PSU] Add switch debouncing
    [PSU.brd, PSU.sch]
2023-04-11 [HW/PSU] Correct resistor values
    [PSU.brd, PSU.sch]
2023-04-14 [HW/PSU] Fix Vbat to Vin voltage leak
    [PSU.brd, PSU.sch]
