kuba2k2/T1200/(notices)

Notices in the files:
ExpAdapter/hardware/v1.0/ExpAdapter_v1.0.brd:
TS-30 © kuba2k2
PSU/hardware/PSU.brd:
© kuba2k2
parts and their libraries:
SparkFun-Connectors: Licensing: Creative Commons ShareAlike 4.0 International - https://creativecommons.org/licenses/by-sa/4.0
